enricocirignaco/ProjectVenus/README.md

# ProjectVenus
HugeRedButton - Device  with big button that emulate tv remote  and facilitate turning on/ff tv for elderly people 

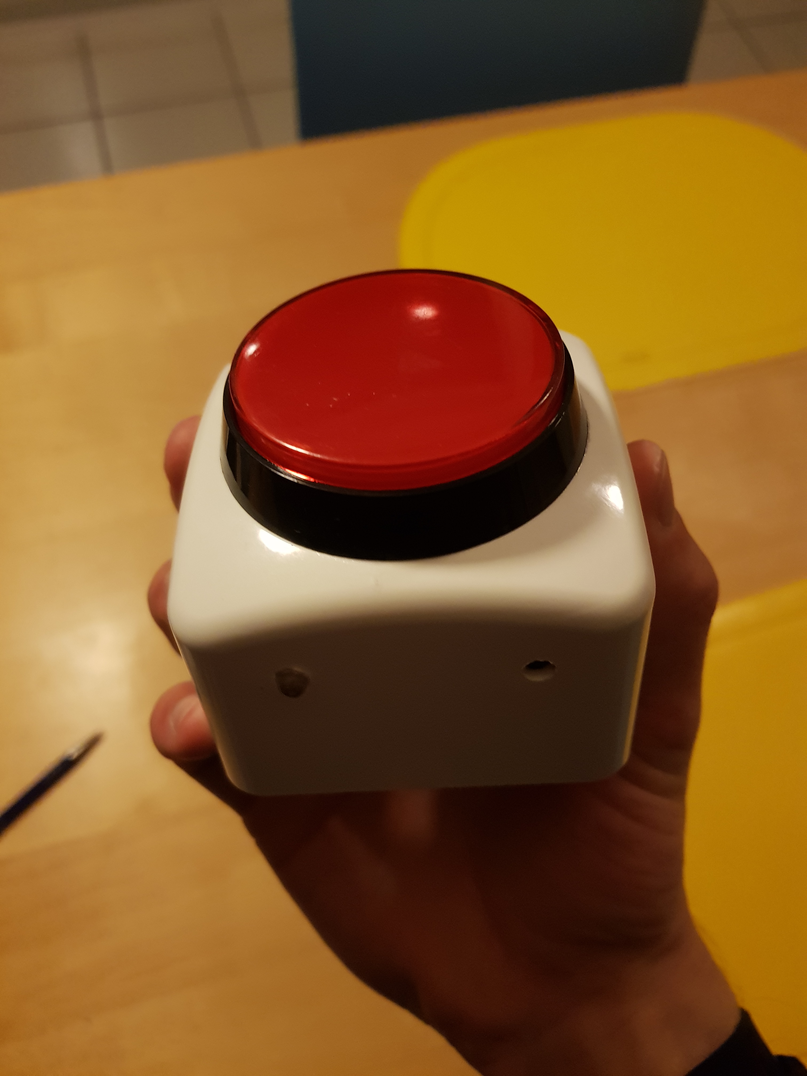
[picture p1: pics/20190125_235534.jpg]
