enricocirignaco/ProjectVenus/pics/20190125_183636.jpg

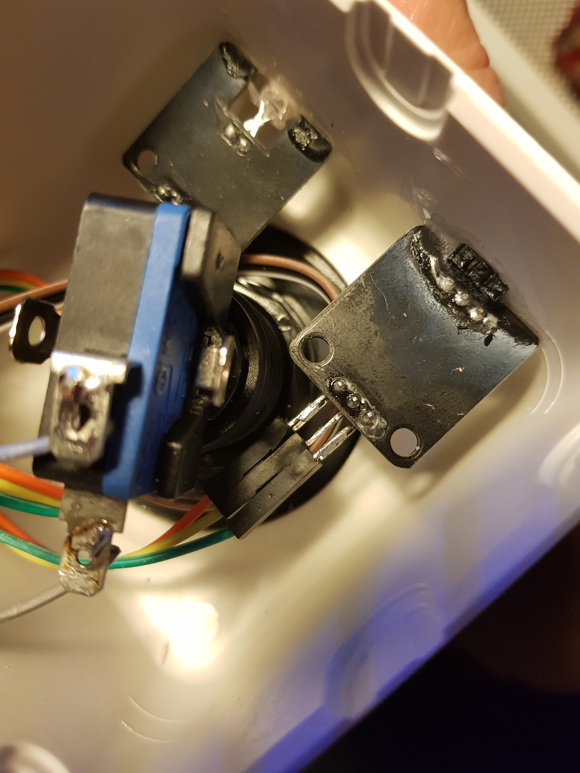
pics/20190125_183636.jpg
