enricocirignaco/ProjectVenus/pics/20190125_235542.jpg

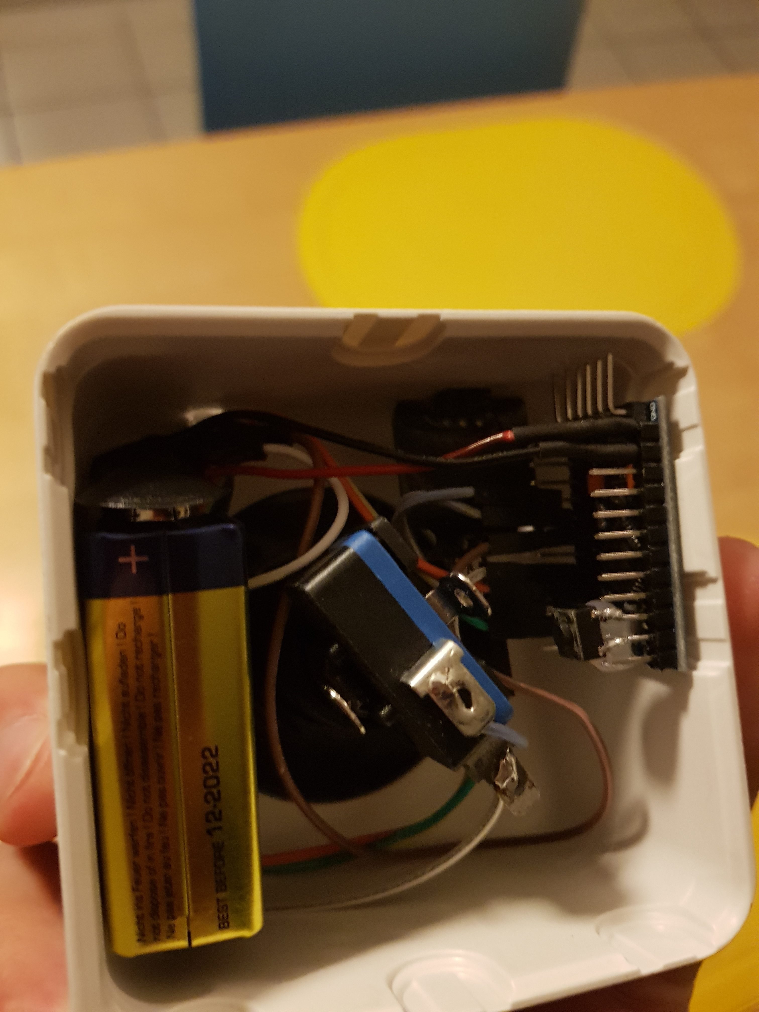
pics/20190125_235542.jpg
