enricocirignaco/ProjectVenus/pics/20190125_235559.jpg

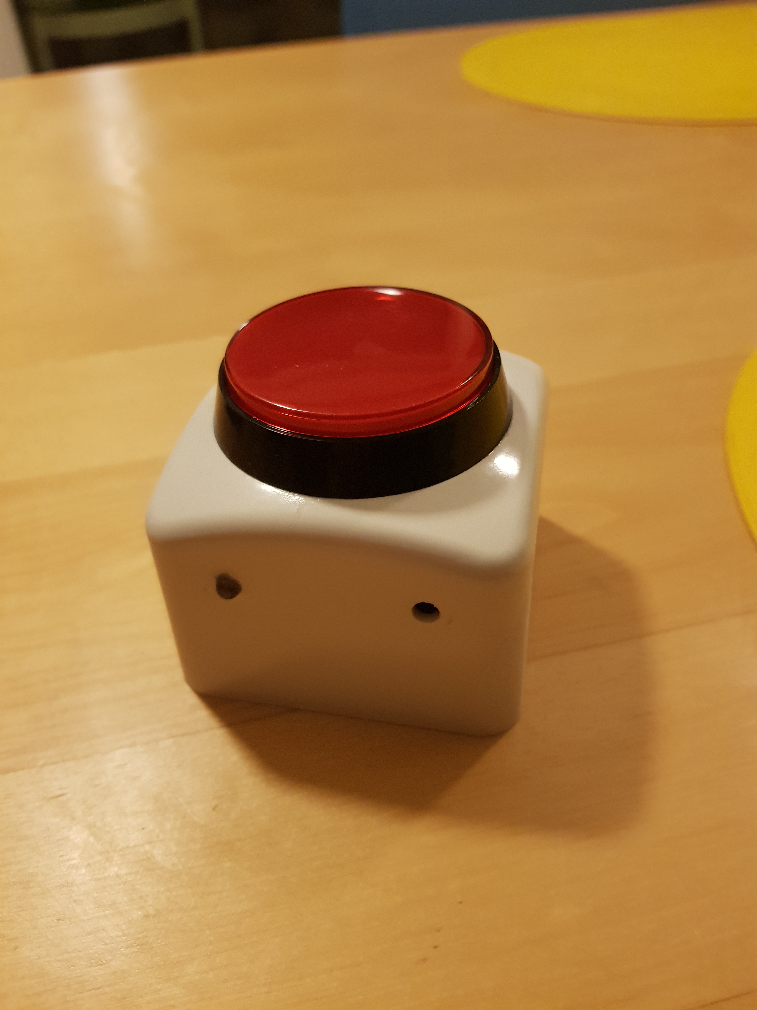
pics/20190125_235559.jpg
