enricocirignaco/ProjectVenus/Huge_Red_Button_schema.pdf

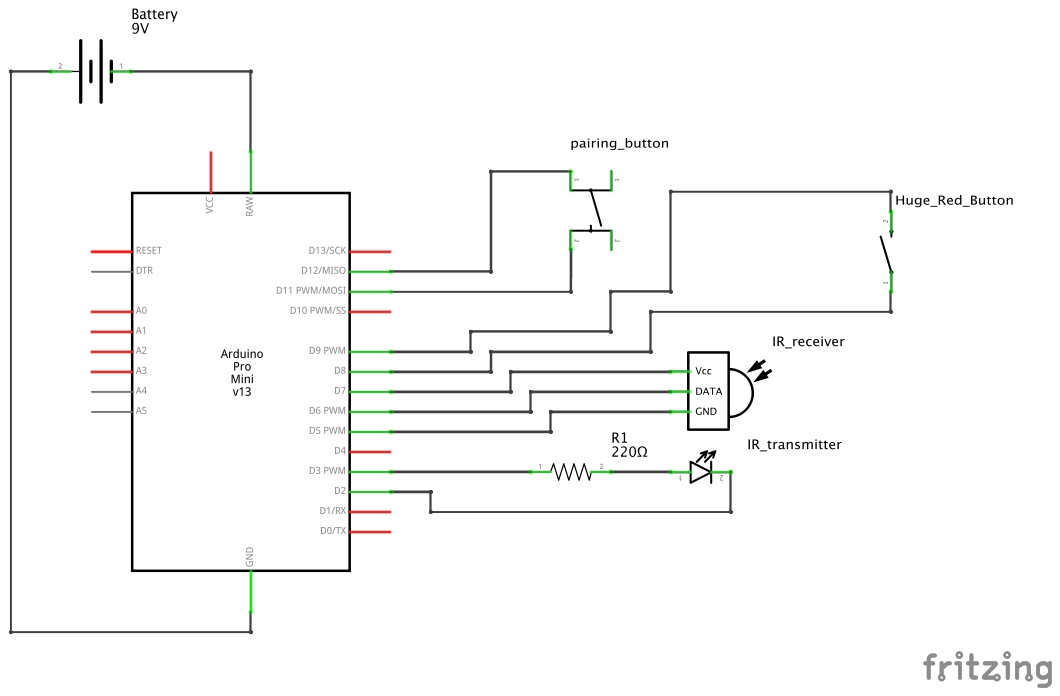
[picture p7: page 1]
